Vinh1VT/SmartGreenhouse/Iot_PCB/Convertisseur_DC_DC/RFM-0505S.step

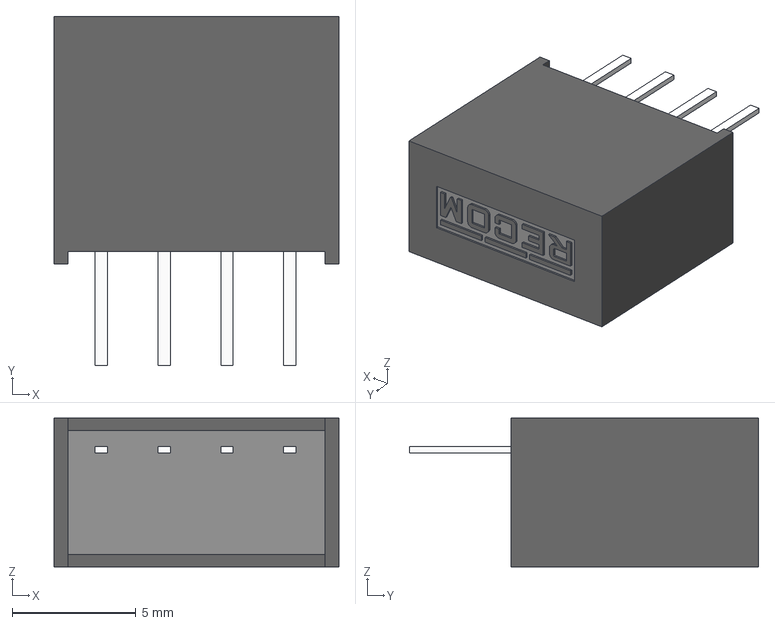
[picture p1: CAD file, 2026-03-12]
Iot_PCB/Convertisseur_DC_DC/RFM-0505S.step
11.5 x 14.1 x 6.00 mm
