Vinh1VT/SmartGreenhouse/Iot_PCB/FDC6326L/FDC6326L.step

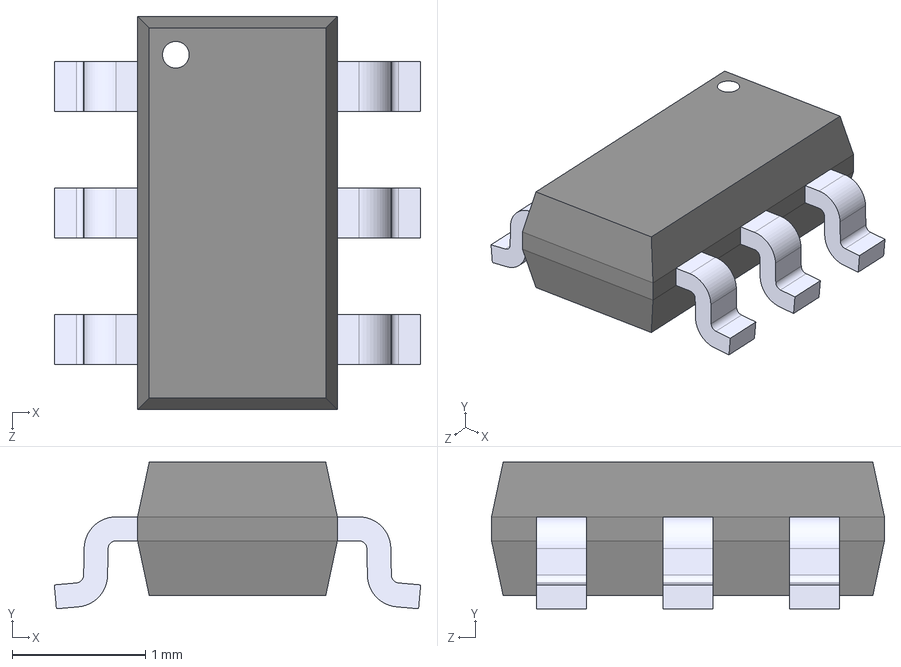
[picture p2: CAD file, 2026-02-26]
Iot_PCB/FDC6326L/FDC6326L.step
2.75 x 1.10 x 2.95 mm
