Vinh1VT/SmartGreenhouse/Iot_PCB/libs_custom/kicad_lib_upesy-master/assets/step_model/upesy_protoboard_medium.step

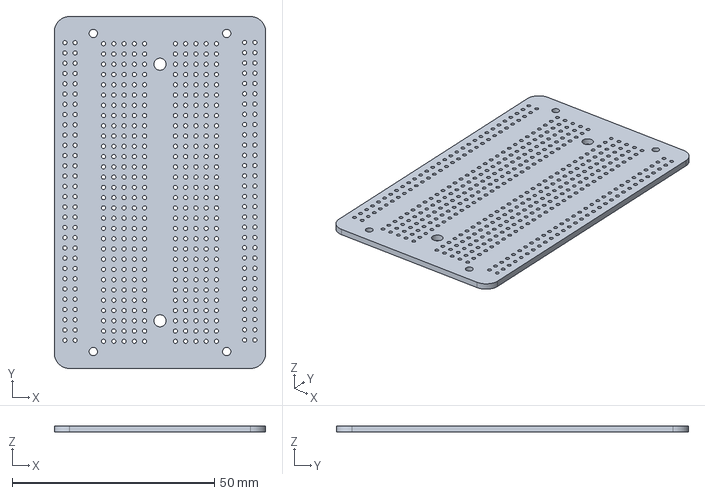
[picture p3: CAD file, 2026-03-02]
Iot_PCB/libs_custom/kicad_lib_upesy-master/assets/step_model/upesy_protoboard_medium.step
52.3 x 87.1 x 1.60 mm
