Vinh1VT/SmartGreenhouse/Iot_PCB/Projet_Iot/Projet_Iot.stl

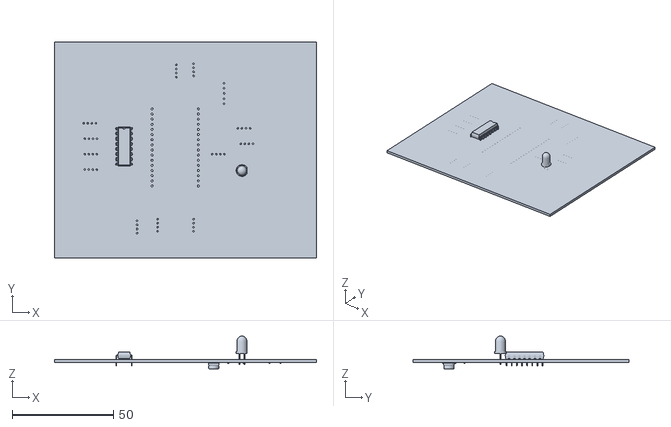
[picture p4: CAD file, 2026-03-12]
Iot_PCB/Projet_Iot/Projet_Iot.stl
129.5 x 106.7 x 16.3
