Vinh1VT/SmartGreenhouse/Iot_PCB/libs_custom/kicad_lib_upesy-master/assets/step_model/upesy_protoboard_mini.step

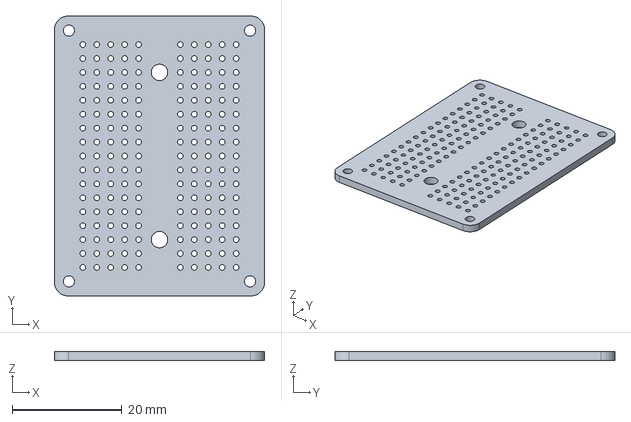
[picture p5: CAD file, 2026-03-02]
Iot_PCB/libs_custom/kicad_lib_upesy-master/assets/step_model/upesy_protoboard_mini.step
38.4 x 51.1 x 1.60 mm
