Vinh1VT/SmartGreenhouse/Iot_PCB/libs_custom/kicad_lib_upesy-master/assets/step_model/upesy_breadboard_medium.step

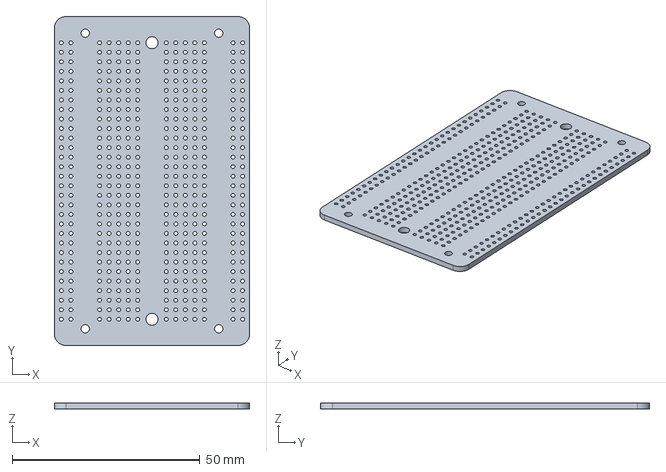
[picture p6: CAD file, 2026-03-02]
Iot_PCB/libs_custom/kicad_lib_upesy-master/assets/step_model/upesy_breadboard_medium.step
52.1 x 87.6 x 1.60 mm
