Vinh1VT/SmartGreenhouse/Iot_PCB/Grove/110990030.step

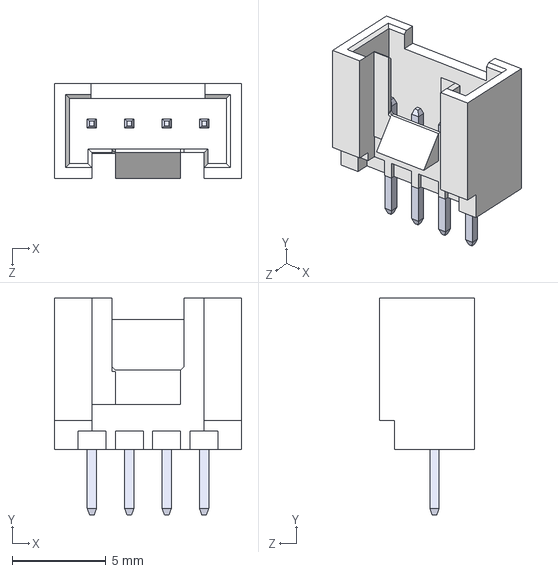
[picture p7: CAD file, 2026-02-25]
Iot_PCB/Grove/110990030.step
10.0 x 11.6 x 5.10 mm
