Vinh1VT/SmartGreenhouse/(list of files, cad)

Other CAD files:
Iot_PCB/libs_custom/kicad_lib_upesy-master/assets/step_model/upesy_breadboard_mini.step
