Vinh1VT/SmartGreenhouse/Iot_PCB/Projet_Iot/Projet_Iot.kicad_pcb

## KiCad design Iot_PCB/Projet_Iot/Projet_Iot.kicad_pcb (2026-03-31)

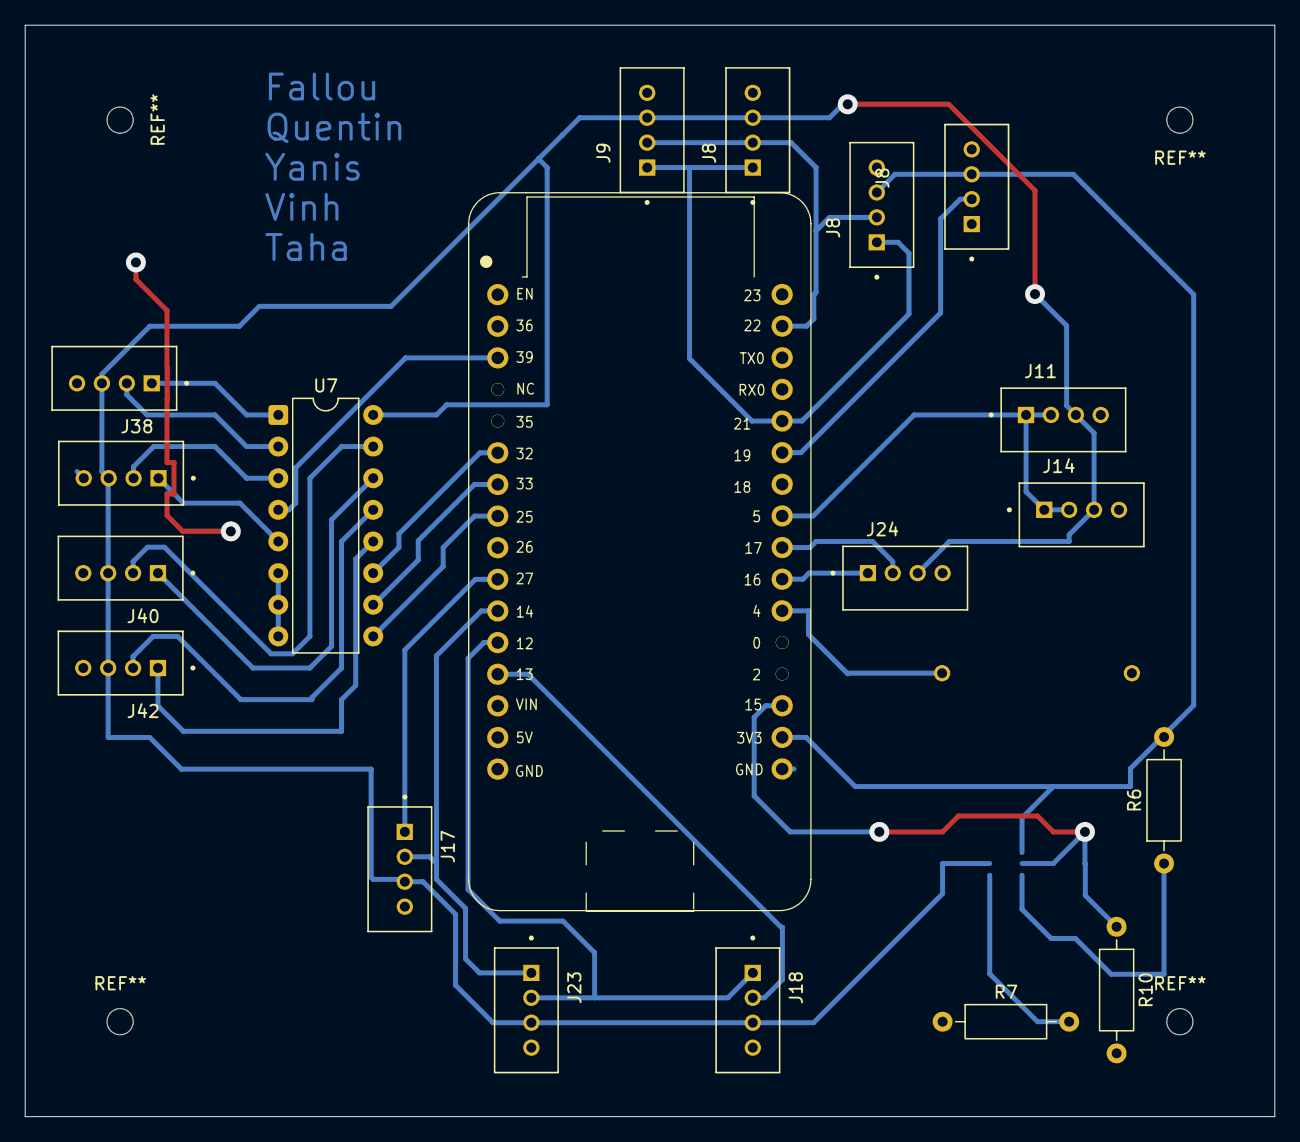
[picture p8: board Projet_Iot.kicad_pcb from above]

Board: 2 copper layers, 100.3 x 87.6 mm, 20 parts (1 on the bottom side), 28 nets.

Parts:
J8, J8#2, J8#3, J9, J11, J14, J17, J18, J23, J24, J36, J38, J40, J42: 110990030; SEEED_110990030
R6: 1000; R_Axial_DIN0207_L6.3mm_D2.5mm_P10.16mm_Horizontal
R7: 100; R_Axial_DIN0207_L6.3mm_D2.5mm_P10.16mm_Horizontal
R10: 4700; R_Axial_DIN0207_L6.3mm_D2.5mm_P10.16mm_Horizontal
U6: uPesy_ESP32_Wroom_Low_Power_DevKit
U7: mx8v1_74LS151; DIP-16_W7.62mm
U11: FDC6326L; SOT95P280X110-6N

Connections:
/1_Wire: J11.1, J11.2, J14.1, J14.2, U6.24 (GPIO5)
/3v3: J8#3.3, J9.3, J11.3, J14.3, J17.3, J18.3, J23.3, J24.3, J36.3, J38.3, J40.3, J42.3, U7.16 (VCC), U11.2 (VOUT,C1_2)
/3v3_ESP: J8.3, J8#2.3, R6.2, U6.31 (3V3), U11.4 (VIN,R1)
/ADC1_S0: U6.6 (GPIO32), U7.11 (S0)
/ADC1_S1: U6.7 (GPIO33), U7.10 (S1)
/ADC1_S2: U6.8 (GPIO25), U7.9 (S2)
/ADC2: U6.3 (GPIO39), U7.4 (I0)
/Enable_LS: R10.1, U6.30 (GPIO15), U11.5 (ON/OFF)
/GND: J8.4, J8#2.4, J8#3.4, J9.4, J11.4, J14.4, J17.4, J18.4, J23.4, J24.4, J36.4, J38.4, J40.4, J42.4, R7.1, R10.2, U6.32 (GND), U7.6 (~Z), U7.7 (~E), U7.8 (GND)
/Grove1-1: J17.1, U6.10 (GPIO27)
/Grove1-2: J17.2, J23.1, U6.11 (GPIO14)
/Grove2-3: J18.1, J23.2, U6.12 (GPIO12)
/Grove3-3: J18.2, U6.13 (GPIO13)
/Mux8v1_capt_hum1/Hum0: J36.1, U7.5 (Z)
/Mux8v1_capt_hum1/Hum1: J36.2, U7.3 (I1)
/Mux8v1_capt_hum1/Hum2: J38.2, U7.2 (I2)
/Mux8v1_capt_hum1/Hum3: J38.1, U7.1 (I3)
/Mux8v1_capt_hum1/Hum4: J40.2, U7.15 (I4)
/Mux8v1_capt_hum1/Hum5: J40.1, U7.14 (I5)
/Mux8v1_capt_hum1/Hum6: J42.2, U7.13 (I6)
/Mux8v1_capt_hum1/Hum7: J42.1, U7.12 (I7)
/SDA: J8.1, J8#3.1, J9.1, U6.21 (GPIO21)
/SDL: J8.2, J8#3.2, J9.2, U6.18 (GPIO22)
/interrupt_ia: J8#2.2, U6.22 (GPIO19)
unnamed: J24.1, U6.26 (GPIO16)
unnamed: J24.2, U6.25 (GPIO17)
unnamed: R6.1, U11.6 (R1,C1)
unnamed: R7.2, U11.1 (R2)
