Vinh1VT/SmartGreenhouse/Iot_PCB/PCB_ventillateur/controle_ventillateur/controle_ventillateur.kicad_pcb

## KiCad design Iot_PCB/PCB_ventillateur/controle_ventillateur/controle_ventillateur.kicad_pcb (2026-03-31)

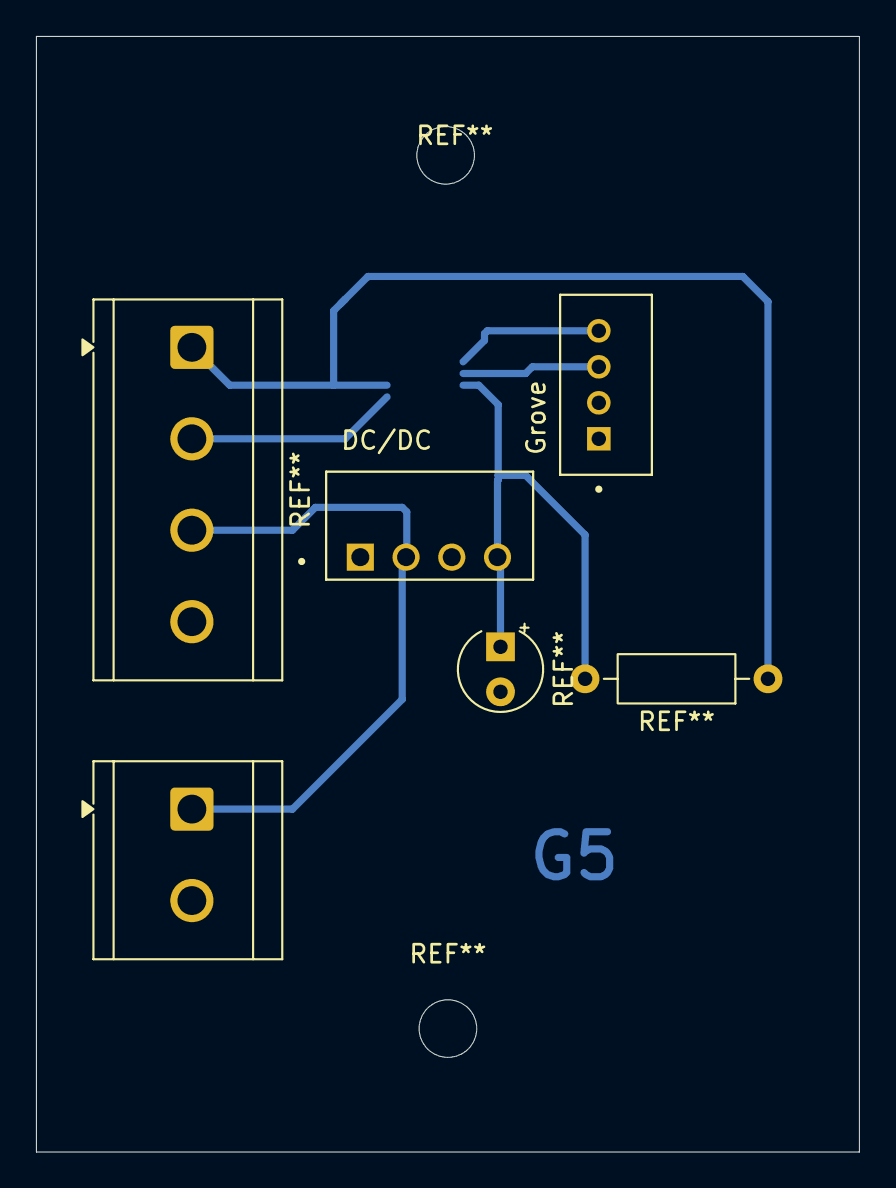
[picture p9: board controle_ventillateur.kicad_pcb from above]

Board: 2 copper layers, 45.7 x 62.0 mm, 3 parts (1 on the bottom side), 4 nets.

Parts:
DC/DC: CONV_RFM-0505S
Grove: SEEED_110990030
U7: EMC2301-x-ACZL; MSOP-8_3x3mm_P0.65mm

Connections:
/GND: DC/DC.1, DC/DC.3, Grove.1, U7.4 (GND)
/SCL: Grove.3, U7.2 (SMCLK)
/SDA: Grove.4, U7.1 (SMDATA)
unnamed: DC/DC.4, U7.3 (VDD)
