Vinh1VT/SmartGreenhouse/SmartgreenhouseKicad/SmartgreenhouseKicad.kicad_sch

## KiCad design SmartgreenhouseKicad/SmartgreenhouseKicad.kicad_sch (2026-02-24)

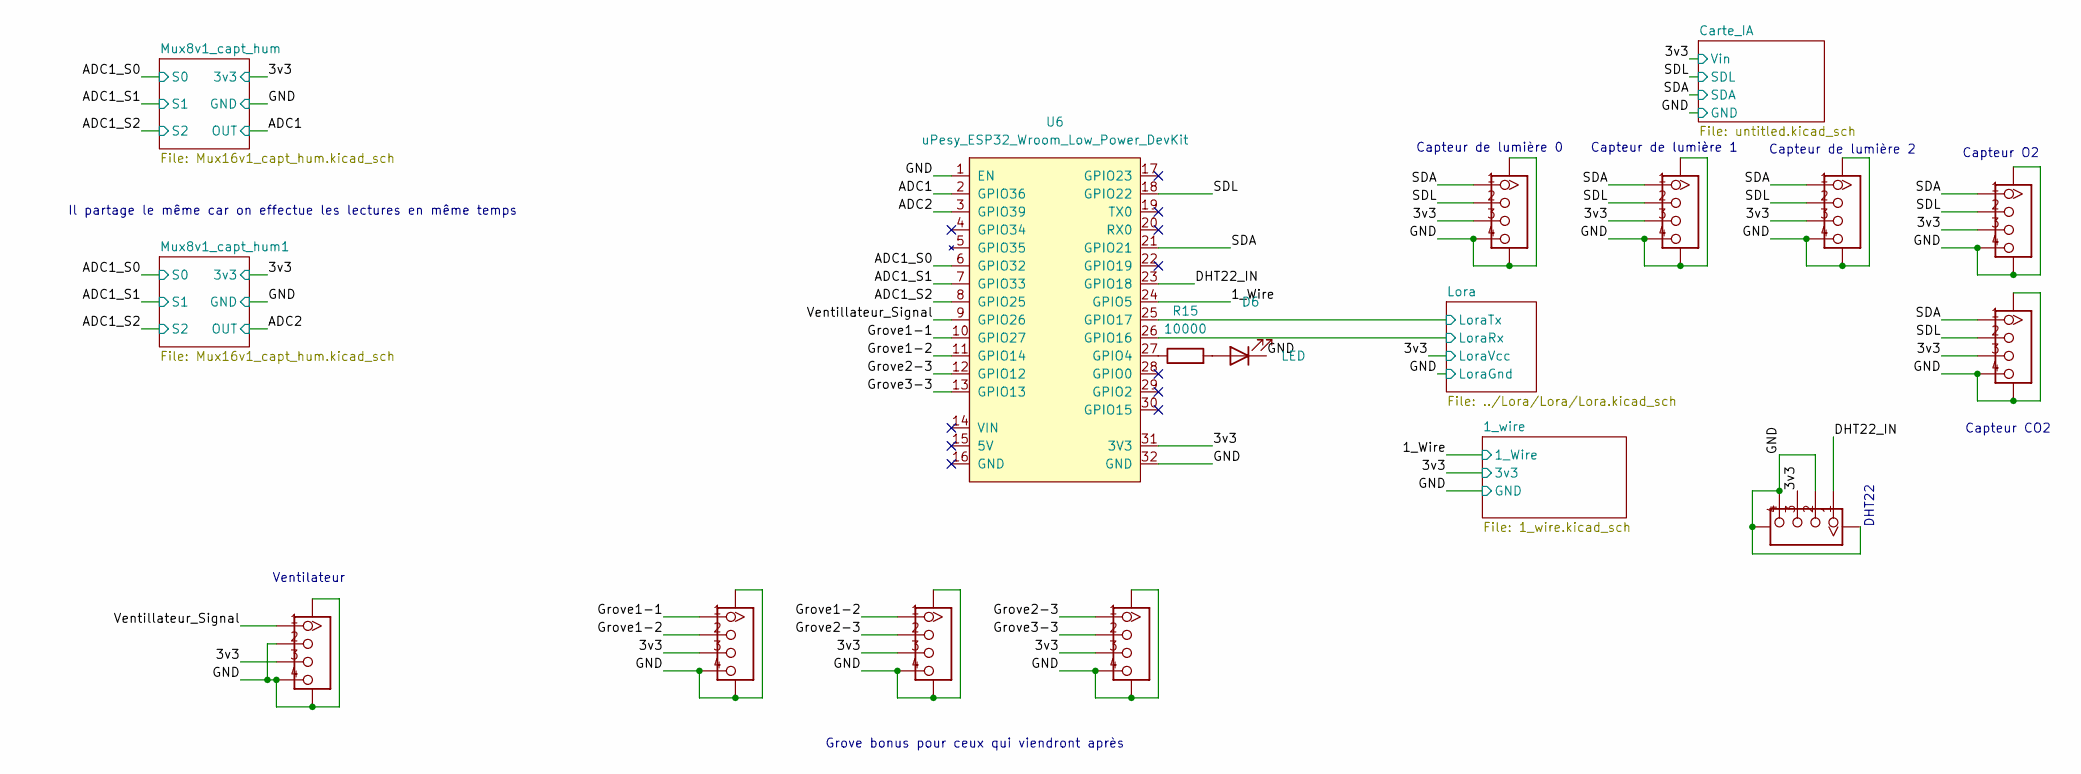
[picture p10: schematic SmartgreenhouseKicad.kicad_sch]

Parts:
D6: LED
J6, J7, J8, J9, J10, J23, J40, J41, J42, J43: HW4-SMD-2.0
R15: 10000
U6: uPesy_ESP32_Wroom_Low_Power_DevKit

Connections:
1_Wire: U6.24 (GPIO5)
3v3: J6.3, J7.3, J8.3, J9.3, J10.3, J23.3, J40.3, J41.3, J42.3, J43.3, U6.31 (3V3)
ADC1: U6.2 (GPIO36)
ADC1_S0: U6.6 (GPIO32)
ADC1_S1: U6.7 (GPIO33)
ADC1_S2: U6.8 (GPIO25)
ADC2: U6.3 (GPIO39)
DHT22_IN: J23.1, U6.23 (GPIO18)
GND: D6.1 (K), J6.4, J6.SS1, J6.SS2, J7.4, J7.SS1, J7.SS2, J8.4, J8.SS1, J8.SS2, J9.4, J9.SS1, J9.SS2, J10.4, J10.SS1, J10.SS2, J23.2, J23.4, J23.SS1, J23.SS2, J40.2, J40.4, J40.SS1, J40.SS2, J41.4, J41.SS1, J41.SS2, J42.4, J42.SS1, J42.SS2, J43.4, J43.SS1, J43.SS2, U6.1 (EN), U6.32 (GND)
Grove1-1: J43.1, U6.10 (GPIO27)
Grove1-2: J41.1, J43.2, U6.11 (GPIO14)
Grove2-3: J41.2, J42.1, U6.12 (GPIO12)
Grove3-3: J42.2, U6.13 (GPIO13)
LoraRx: U6.26 (GPIO16)
LoraTx: U6.25 (GPIO17)
unnamed: D6.2 (A), R15.2
unnamed: R15.1, U6.27 (GPIO4)
SDA: J6.1, J7.1, J8.1, J9.1, J10.1, U6.21 (GPIO21)
SDL: J6.2, J7.2, J8.2, J9.2, J10.2, U6.18 (GPIO22)
Ventillateur_Signal: J40.1, U6.9 (GPIO26)

Notes on the sheet:
Capteur de lumière 2
Capteur CO2
Grove bonus pour ceux qui viendront après
Capteur de lumière 0
Ventilateur
Il partage le même car on effectue les lectures en même temps
Capteur O2
DHT22
Capteur de lumière 1
