Vinh1VT/SmartGreenhouse/code_esp32_WROOM_32E/driver_IA.hpp

#ifndef DRIVER_IA_H
#define DRIVER_IA_H

#include "sensor_Data.h"

#define PATE_IA_RX 12 //je ne sais pas quoi mettre pour l'instant
#define PATE_IA_TX 14 //je ne sais pas quoi mettre pour l'instant

#define QUERY_NUMBER 4

void get_data_IA(struct SensorData &data);

#endif
