Vinh1VT/SmartGreenhouse/code_esp32_WROOM_32E/driver_lux.hpp

#ifndef DRIVER_LUX_HPP
#define DRIVER_LUX_HPP
#include "Wire.h"
#include "sensor_Data.h"


#define ADDR_LUX_ETANCHE 0x23                 //I2C address 0x23
#define ADDR_LUX_NP1 0x38
#define ADDR_LUX_NP2 0x39

uint8_t readReg_lux_etanche(uint8_t reg, const void* pBuf, size_t size);
void setup_lux_etanche();
void readfull_lux_etanche(SensorData& data);

void initBH1745(uint8_t address);
void readBH1745(uint8_t address, uint8_t index);
void writeReg(uint8_t address, uint8_t reg, uint8_t value);
bool readReg_BH1745(uint8_t addr, uint8_t reg, uint8_t* data, uint8_t len);

#endif
