Vinh1VT/SmartGreenhouse/code_esp32_WROOM_32E/read_temp_DS18B20.h

#ifndef READ_TEMP_DS18B20_H
#define READ_TEMP_DS18B20_H

#include "sensor_Data.h"

#ifndef NB_SENSORS_DS18B20
    #define NB_SENSORS_DS18B20 4
#endif

#ifndef PIN_ONE_WIRE_DS18B20
    #define PIN_ONE_WIRE_DS18B20 5
#endif

/**/
byte addr[NB_SENSORS_DS18B20][8] = {{0x28, 0x4d, 0x1d, 0x68, 0x10, 0x00, 0x00, 0x77}, {0x28, 0x2e, 0x6c, 0x68, 0x10, 0x00, 0x00, 0x4d}, {0x28, 0x51, 0x93, 0xd5, 0x0b, 0x00, 0x00, 0xbf}, {0x28, 0xa5, 0x37, 0x68, 0x10, 0x00, 0x00, 0xba}};

#if DEBUG == 1
void print_addr(void);
#endif

void read_temperature_ds18b20(SensorData& data);

#endif
