Vinh1VT/SmartGreenhouse/(commit log)

2026-02-18 build(esp32) : add code_esp32_WROOM_32E.ino
    add the start of an esp32 project
2026-02-18 build(esp32) : add driver_UART header and c files
    add the start of files to use the UART module of the esp32, function init added
2026-02-19 build: Add readme
    Add a readme for using the server in it's current state
2026-02-23 build(esp32) : add function write_UART to driver_UART
2026-02-23 build(esp32) : add functions to read from UART
    add function read_byte, read_bytes and read_until
2026-02-23 fix(esp32) : correct problem that made the code impossible to compile
    [driver_UART.ino]
2026-02-23 build(esp32) : add function to command the LoRa module
2026-02-23 fix(esp32) : correct a forgotten typo
    [driver_LoRa.ino]
2026-02-23 fix(esp32) : remove a forgoten useless function call
    [driver_LoRa.ino]
2026-02-23 fix(esp32) : change a function to correct a problem
    [driver_LoRa.ino]
2026-02-23 test(esp32) : analog reading working, mux control is not tho
2026-02-24 build(Server) : Add fan historic to the python script
2026-02-24 fix(esp32) : working mux with pins in define (i believe)
    [driver_ana.hpp]
2026-02-24 fix(esp32) : gpios forced at 0 in the end of the function for energy purposes
2026-02-24 build(esp32) : Add functions to read the temperature from ds18b20 sensors
2026-02-24 build(esp32) : add function to read temperature and humidity from one DHT22 sensor
2026-02-24 build(Kicad) : add the kicad files (schematic for now)
    [1_wire.kicad_sch, Mux16v1_capt_hum.kicad_sch, SmartgreenhouseKicad.kicad_pcb, SmartgreenhouseKicad.kicad_sch, untitled.kicad_sch]
2026-02-24 fix(kicad) : update with the latest files
    [1_wire.kicad_sch, Lora.kicad_pcb, Lora.kicad_sch, Mux16v1_capt_hum.kicad_sch, Projet_Iot.kicad_pcb, Projet_Iot.kicad_sch, untitled.kicad_sch]
2026-02-25 Update(esp32) : fix multiple problems found during testing
    [driver_LoRa.h, driver_LoRa.ino, driver_UART.ino]
2026-02-25 Update(esp32) : made a test code to test all other code in one file
2026-02-25 build(esp32) : add function to convert sensor data to ttn payload
2026-02-25 remplacement des grove lora par des vrais
    [110990030.step, 1_wire.kicad_sch, Mux16v1_capt_hum.kicad_sch, Projet_Iot.kicad_sch, untitled.kicad_sch]
2026-02-26 update 1-wire, pull_up i2c, switch load added but not configured yet (wait for test)
    [1_wire.kicad_sch, FDC6326L.step, Mux16v1_capt_hum.kicad_sch, Projet_Iot.kicad_sch]
2026-03-02 build(esp32) : add the function to convert payload to hexstring
2026-03-02 fix(esp32): correct send LoRa function, to use MSGHEX
    [driver_LoRa.ino]
2026-03-02 adding grove to replace lora
    [Projet_Iot.kicad_pcb, Projet_Iot.kicad_sch]
2026-03-02 build(kicad): add a trace to every schematic
    [1_wire.kicad_sch, Mux16v1_capt_hum.kicad_sch, Projet_Iot.kicad_sch, untitled.kicad_sch]
2026-03-02 test(esp32) : test a commit y'a r y'a r
2026-03-02 ijustwanttopull(esp32) : commit pour pouvoir pull rebase
2026-03-02 modif(esp32) ajout du driver pour le switch load et quelque changements autour
2026-03-02 fix(esp32) : le capteur de lumiere I2C fonctionne quand soudé
    [driver_lux.ino]
2026-03-02 build(kicad) : start PCB
    [1_wire.kicad_sch, Mux16v1_capt_hum.kicad_sch, Projet_Iot.kicad_pcb, Projet_Iot.kicad_sch, upesy_breadboard_medium.step, upesy_breadboard_mini.step, upesy_protoboard_medium.step, upesy_protoboard_mini.step]
2026-03-02 modif(esp32) : add 2 temperature values
2026-03-02 modif(esp32) : add function to support the new way of sending information
2026-03-02 new(esp32) : deep sleep
2026-03-05 pcb mis à jour
    [Projet_Iot.kicad_pcb, Projet_Iot.kicad_sch, upesy_breadboard_medium.step, upesy_breadboard_mini.step, upesy_protoboard_medium.step, upesy_protoboard_mini.step]
2026-03-09 fix(esp32) : Correct deep sleep and load switch function
    [deep_sleep.ino, driver_load_switch.ino]
2026-03-09 modif(esp32) : change success condition of LoRa connection
2026-03-09 modif(esp32) : make the code a little clearer
2026-03-09 modif(esp32) : forgot to include this file in the former commit
2026-03-09 modif(esp32) : update the reading send by the payload
2026-03-09 modif(esp32) : update to comply with new payload
2026-03-09 build(esp32) : add the beginning of main loop
2026-03-09 patch(Esp32) : remove the fan data from the uplink structure
2026-03-09 modif(esp32) : fix multiple issues, now work on card
    [code_esp32_WROOM_32E.ino, deep_sleep.ino, driver_LoRa.h, driver_LoRa.ino, read_temp_DS18B20.h, read_temp_DS18B20.ino]
2026-03-09 modif(esp32) : coorect some names
2026-03-09 ajout driver gaz
2026-03-09 working(esp32) : je fait l'i2c des gaz
2026-03-09 drivers(esp32) : les drivers sont normalement complet, plus qu'a integrer sur le main
2026-03-09 modif(esp32) : change a bunch of thing, now work with the load switch
2026-03-09 modif(esp32) : fix the header name
    [driver_SCD41.ino]
2026-03-09 modif(esp32) : add reading of lux and ambiant hum and temp
2026-03-09 pcb and schematic up to date
    [Mux16v1_capt_hum.kicad_sch, Projet_Iot.kicad_pcb, Projet_Iot.kicad_sch, untitled.kicad_sch, ventillateur_compmande.kicad_sch]
2026-03-09 pcb upgraded, adding the forgotten capacitor
    [Projet_Iot.kicad_pcb]
2026-03-10 build(AI) : add the I2C slave code
2026-03-10 modif(esp32) : change the init function to get rid of the while loop
2026-03-10 modif(esp32) : fix an issue where the message did not have time to get sent
    [driver_LoRa.ino]
2026-03-10 modif(esp32) : fix a probleme of operation priority
    [read_temp_DS18B20.ino]
2026-03-10 modif(esp32) : replace the read sensors to the BH1745
    [driver_lux.ino]
2026-03-10 modif(esp32) : implement the changes made previously
2026-03-12 final version of pcb
    [Lora.kicad_pcb, Lora.kicad_sch, Projet_Iot.kicad_pcb, Projet_Iot.kicad_sch, Projet_Iot.stl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]
2026-03-14 new(esp32) driver IA
2026-03-30 pcb final version for both the gloabl projet and for the ventillator
    [Projet_Iot.kicad_pcb, controle_ventillateur.kicad_pcb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]
2026-03-31 correction pcb final
    [Projet_Iot.kicad_pcb, controle_ventillateur.kicad_pcb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]
2026-03-31 correctif due a une mauvaise manip
    [code_esp32_WROOM_32E.ino, driver_LoRa.h, driver_LoRa.ino]
2026-04-03 modif(esp32) : fix i2c problem from luminosity captor (thanks to yanis) and add a limit to the downlink reader to prevent error
    [driver_LoRa.ino, driver_lux.ino]
2026-04-03 modif(esp32) : add possibility to monitor battery charge (currently sent to tty in pplace of the 02, will be changed later)
2026-04-05 build(IA):replaced the AI, and put the correct code to communicate with main board
    [Code_Nano.ino]
2026-04-06 modif(esp32) : add possibility to get data from AI card
2026-04-08 modif(esp32) : currently flashed on the card (doesn't include downlink)
    [code_esp32_WROOM_32E.ino, driver_LoRa.h, driver_LoRa.ino, read_temp_DS18B20.ino]
2026-04-08 modif(esp32) : attempt to read downlink message
2026-04-08 modif(esp32) : add a default value to the downlink buffer
2026-04-13 modif(Server) : fix du serveur python et de la carte IA
    [Code_Nano.ino]
